CircuitCyborg/Advanced-Weather-Station/Assets/wiringdiagram.png

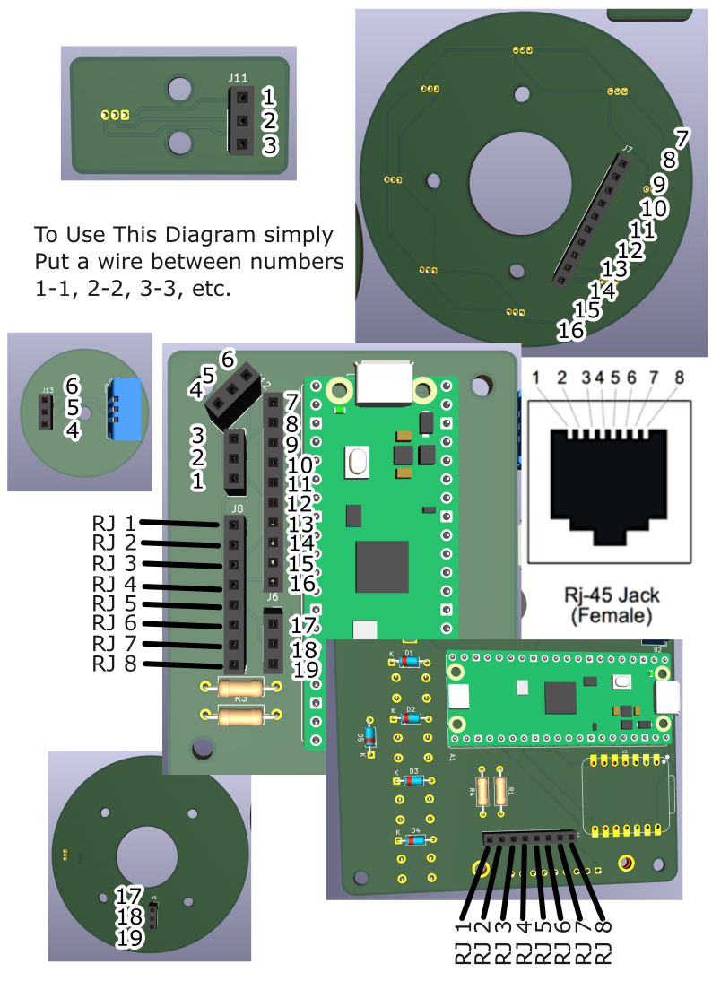
Assets/wiringdiagram.png
