CircuitCyborg/Advanced-Weather-Station/Assets/Layout.png

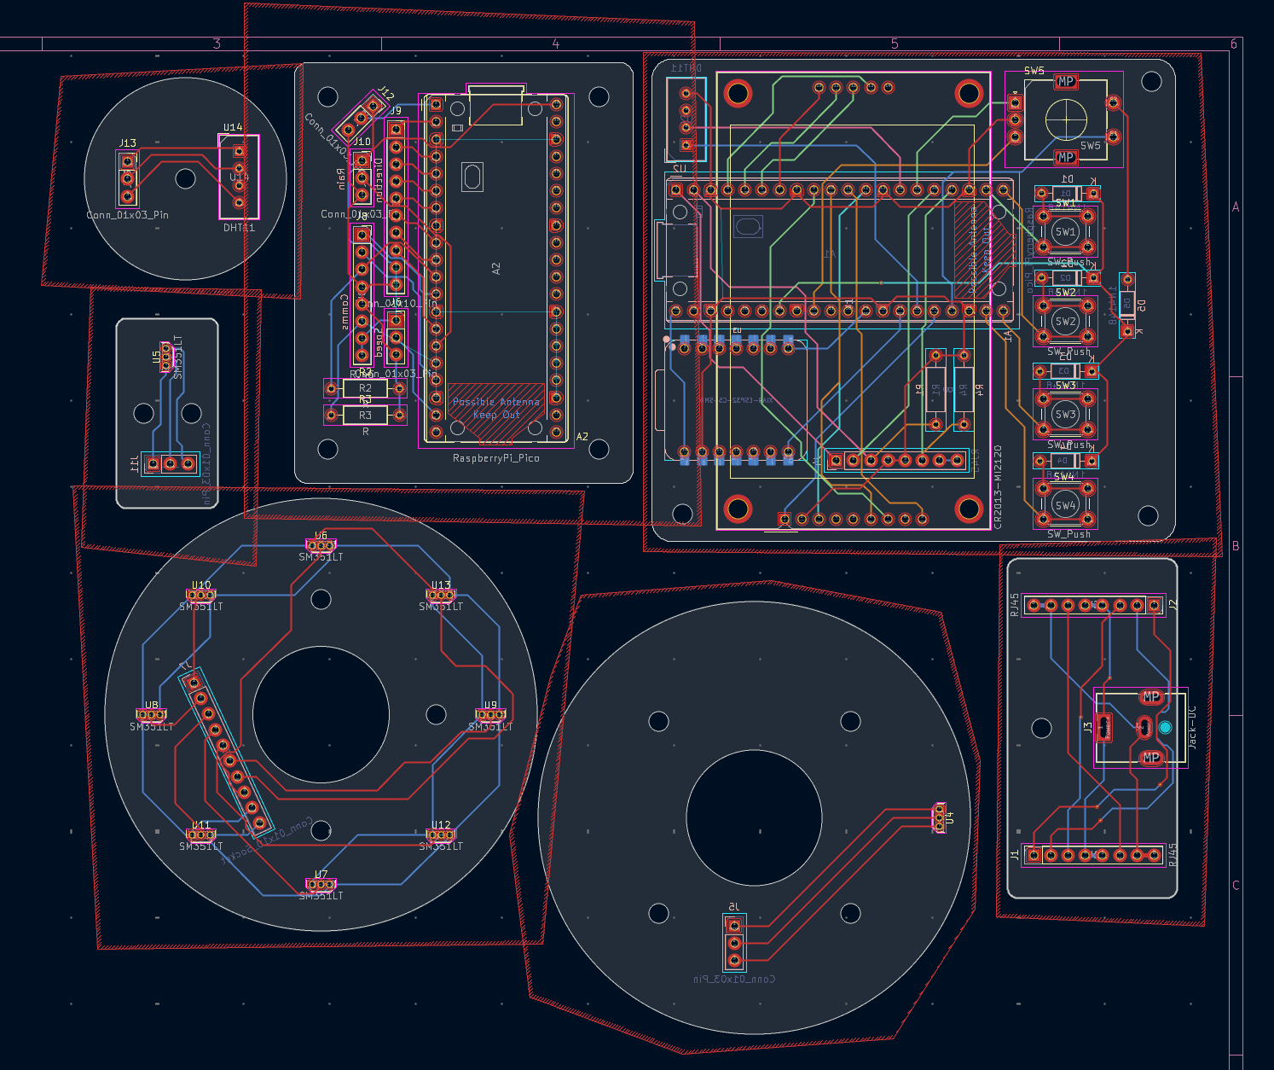
Assets/Layout.png
