CircuitCyborg/Advanced-Weather-Station/Assets/Modules.png

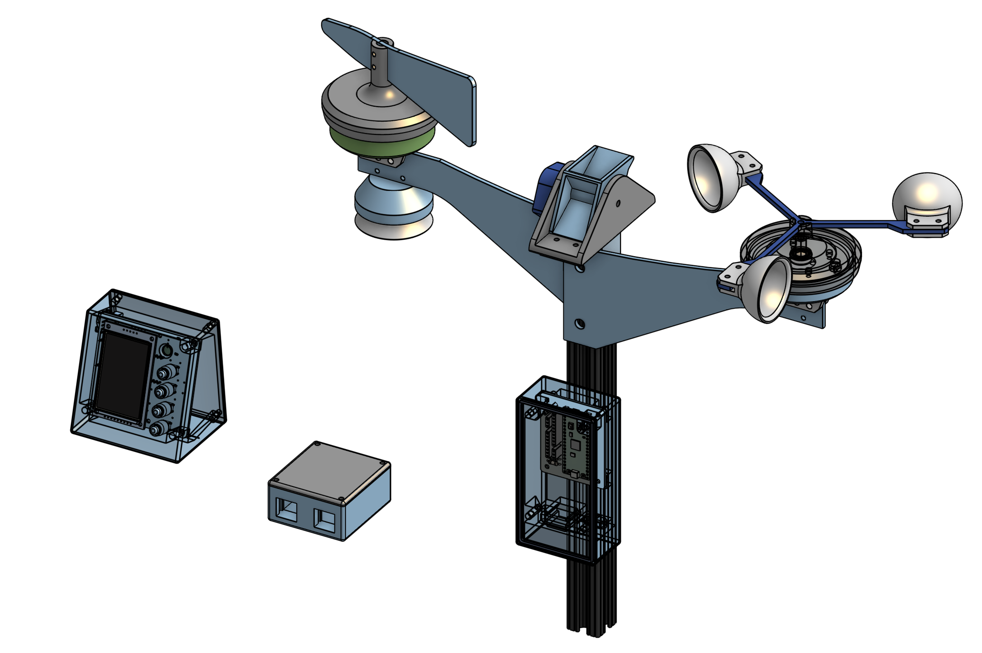
Assets/Modules.png
