CircuitCyborg/Advanced-Weather-Station/Assets/Schematic.png

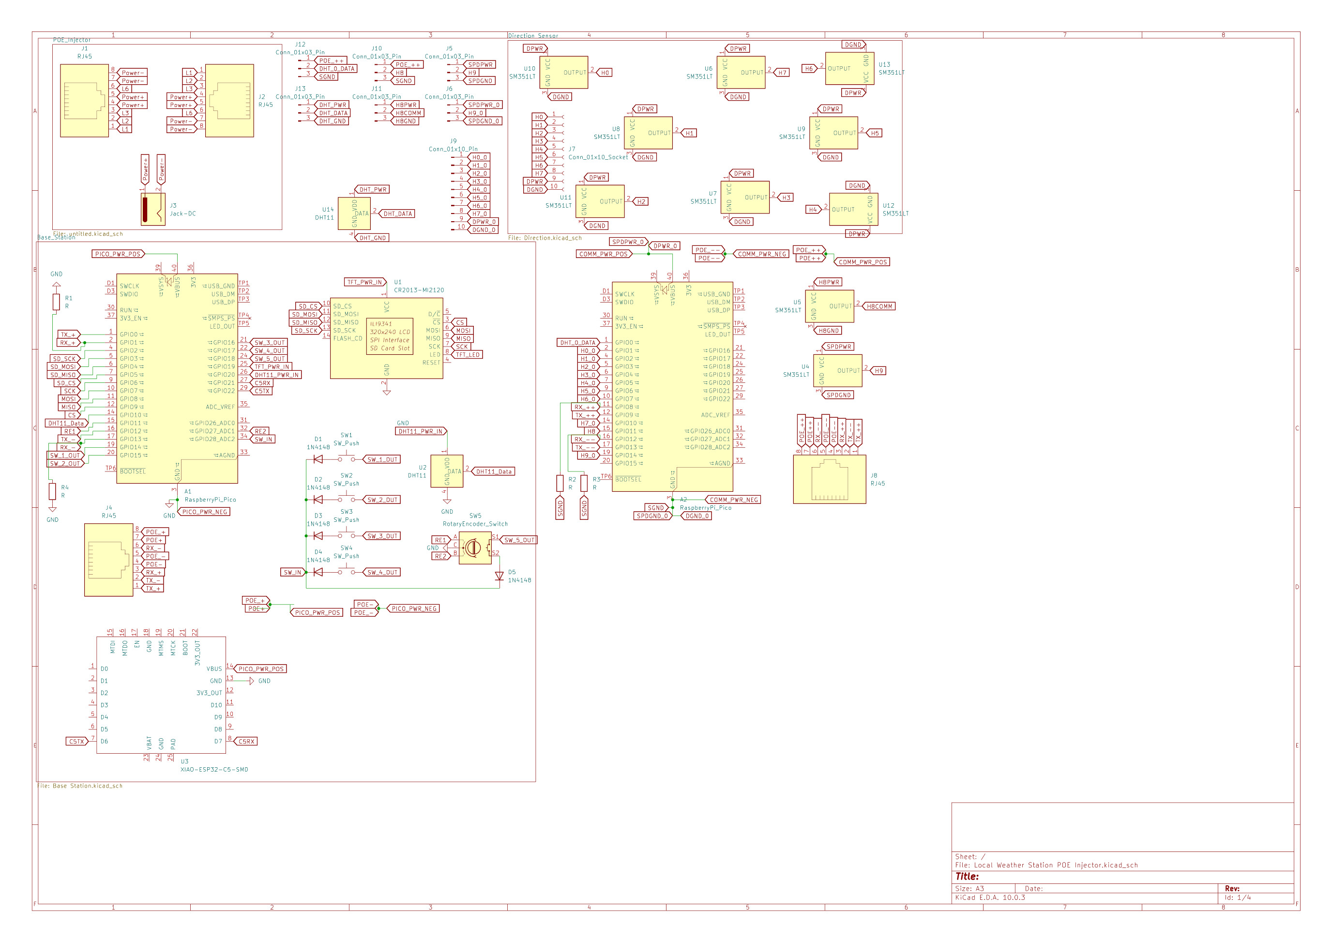
Assets/Schematic.png
