CircuitCyborg/Advanced-Weather-Station/BOM.csv

Item Number | Quantity Needed | Price/Piece | Price for Quantity Needed | Name | Web Link
1. | 2 | $3.95 | $7.90 | AM 2320 Temp and Humidity Sensor | https://www.adafruit.com/product/3721?
2. | 1 | $6.05 | $6.05 | ST7735 TFT Display | https://www.aliexpress.us/item/3256807009276955.html?
3. | 1 / 20 pack | $5.55 | $5.55 | A3144 Hall Sensor | https://www.aliexpress.us/item/3256807009276955.html?
4. | 1 / 10 Piece | $3.76 | $3.76 | 4x10x4 Sealed Flangless Bearing 10 Piece | https://www.aliexpress.us/item/3256807915662185.html?
5. | 2 / 5 Piece | $4.85 | $9.70 | 8x12x3.5 Sealed Flanged Bearings | https://www.aliexpress.us/item/3256809153884282.html?
6. | 1 | $12.31 | $12.31 | Seeed Studio Xiao Esp32-C5 | https://www.aliexpress.us/item/3256811768450465.html?
7. | 2 | $5 | $10 | Raspberry Pi Pico | https://www.adafruit.com/product/4883
8. | 1 | $3.13 | $3.13 | 4.7k ohm resiter 20 pack | https://www.aliexpress.us/item/3256811581264023.html?
9. | 6 | $0.73 | $4.28 | T-Nut Bolt Assembly | https://8020.net/3393.html
10. | 1 | $16.68 | $16.68 | 1010-Black 1x1 t-slot extrusion 24 inch | https://8020.net/1010-black.html
11. | 1 | $3.02 | $3.02 | 5.5x2.5mm Female DC Barrel Jack | https://www.aliexpress.us/item/3256810061502068.html?
12. | 1 | $39.52 | $39.52 | Weather Station PCBs (7 total) | NO LINK (JLC PCB)
13. | 1 | $17.99 | $17.99 | 1/8th in aluminum sheet | https://www.amazon.com/Feelers-Aluminum-Thickness-Protective-Processing/dp/B0BWRQBK73/ref=sr_1_5?
14. | 0 | $2.55 | $0 | EC11E Rotary Encoder | https://www.aliexpress.us/item/3256813351443729.html?
15. | 0 | $1.15 | $0 | 1N4148 THT Diodes | https://www.aliexpress.us/item/3256812018053881.html?
16. | 0 | $1.80 | $0 | 6x6x6 THT Push Button | https://www.aliexpress.us/item/2251832630469941.html?
17. | 0 | $4.19 | $0 | 8x43mm Gobilda Rex Shaft | https://www.gobilda.com/8mm-rex-shaft-with-e-clip-stainless-steel-43mm-length/
18. | 0 | $29.99 | $0 | 100ft Cat 5e cable | https://www.amazon.com/Voltive-Cat5e-Riser-100ft-White/dp/B0F7C79BB1/ref=sr_1_7?
19. | 0 | $11.98 | $0 | Keystone Female RJ45 Jacks | https://www.amazon.com/dp/B0FCBS85S2?ref_=ppx_hzsearch_conn_dt_b_fed_asin_title_3
Total Cost of Needed Items | $151.43 After Tax
Adafruit Total | $19.37
Aliexpress Total | $47.11
JLC PCB Total | $42.78
8020.net Total | $22.69
Amazon | $19.47
