CircuitCyborg/Advanced-Weather-Station/Overall Assy_Advanced_Weather_Station.step

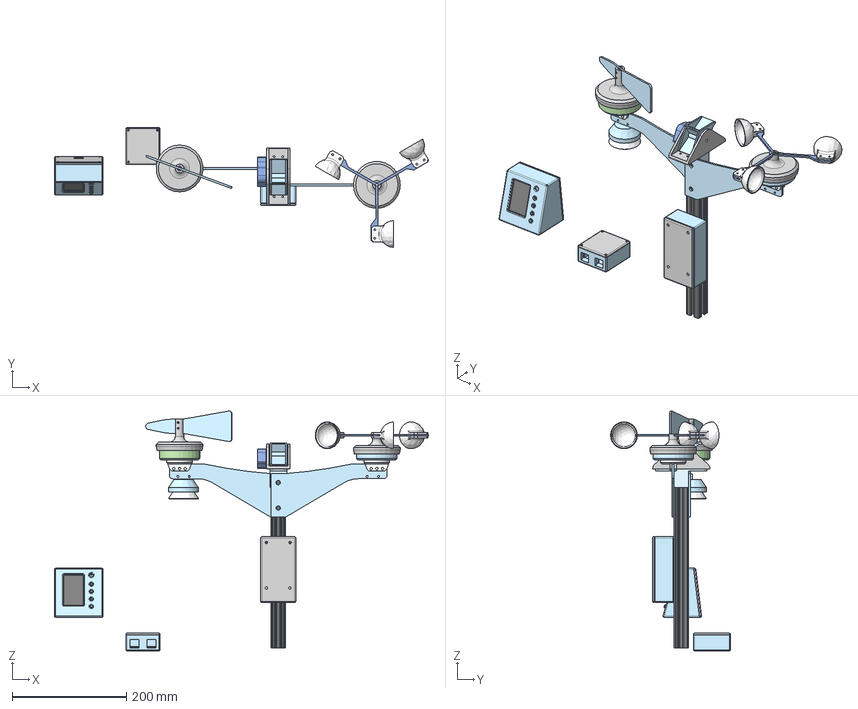
[picture p5: CAD file, 2026-11-01]
Overall Assy_Advanced_Weather_Station.step
654.0 x 209.7 x 419.4 mm
D_DO-35_SOD27_P7.62mm_Horizontal_4 x 2
SW_PUSH_6mm
RaspberryPi_Pico_H_Module_KiCad x 2
D_DO-35_SOD27_P7.62mm_Horizontal_2 x 2
SW_PUSH_6mm_2
D_DO-35_SOD27_P7.62mm_Horizontal x 2
PinSocket_1x08_P2.54mm_Vertical x 2
RaspberryPi_Pico_Header_DIP-40_H2.54mm_KiCad x 2
D_DO-35_SOD27_P7.62mm_Horizontal_3 x 2
Aosong_DHT11_5.5x12.0_P2.54mm
Local Weather Station POE Injector_PCB_7
SW_PUSH_6mm_3
Display_frame_sp x 2
SW_PUSH_6mm_1
Base Station Case Bottom
D_DO-35_SOD27_P7.62mm_Horizontal_1 x 2
R_Axial_DIN0207_L63mm_D25mm_P1016mm_Horizontal_1 x 2
Base Station Case Top
R_Axial_DIN0207_L63mm_D25mm_P1016mm_Horizontal x 2
3382__Imported1 x 2
Local Weather Station POE Injector_PCB_4
TempSensor Top
TempSensor Base
TO-92Flat x 2
Bucket
Mount
MagnetSensor Cover
PinSocket_1x03_P2.54mm_Vertical x 3
Local Weather Station POE Injector_PCB_1
Gasket
DS Mount x 2
outer race x 4
inner race x 4
Windspeed Module Lid
WindSpeedCap
WindSpeedCup x 3
WindSpeedArm
Windspeed Module Base
Local Weather Station POE Injector_PCB_2
Direction Wing
Local Weather Station POE Injector_PCB_6
DirectionCap
Direction Sensor Case Lid
DS Lid Spacer x 3
2106 Series Stainless Steel REX Shaft (8mm Diameter, 43mm Length)
2802 Series Zinc-Plated Steel Button Head Screw (M4 x 0.7mm, 10mm Len gth) 2802-0004-0010
Direction Sensor Case Base
TPU Gasket
Local Weather Station POE Injector_PCB_5
BrainCaseBase
PinSocket_1x03_P2.54mm_Vertical_1
PinSocket_1x03_P2.54mm_Vertical_2
BrainLid
PinSocket_1x10_P2.54mm_Vertical
POE Case Bottom
Local Weather Station POE Injector_PCB_3
BarrelJack_CUI_PJ-063AH_Horizontal
