CircuitCyborg/Advanced-Weather-Station/CAD-Manufacturing/BaseStation/Basestation Main - Base Station Case Top.step

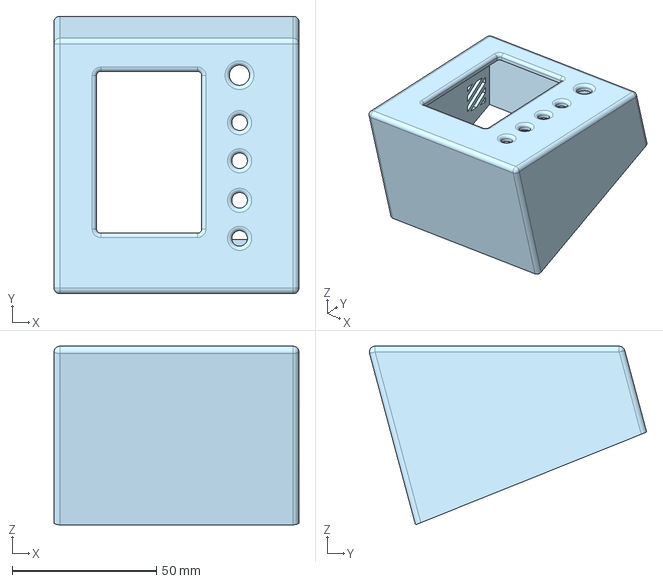
[picture p6: CAD file, 2026-11-01]
CAD-Manufacturing/BaseStation/Basestation Main - Base Station Case Top.step
85.0 x 96.2 x 62.0 mm
