CircuitCyborg/Advanced-Weather-Station/CAD-Manufacturing/BaseStation/Basestation Main - Base Station Case Bottom.step

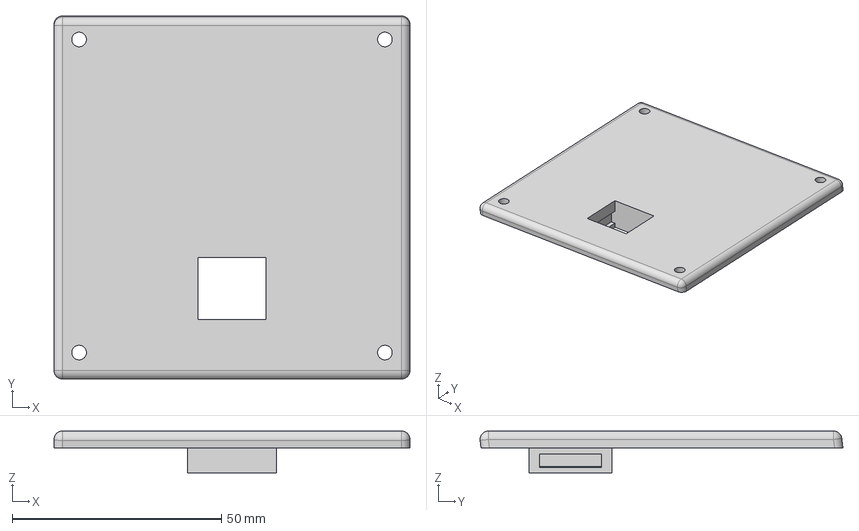
[picture p7: CAD file, 2026-11-01]
CAD-Manufacturing/BaseStation/Basestation Main - Base Station Case Bottom.step
85.0 x 86.7 x 10.0 mm
