CircuitCyborg/Advanced-Weather-Station/CAD-Manufacturing/BaseStation/Extra Parts for Base - Button.step

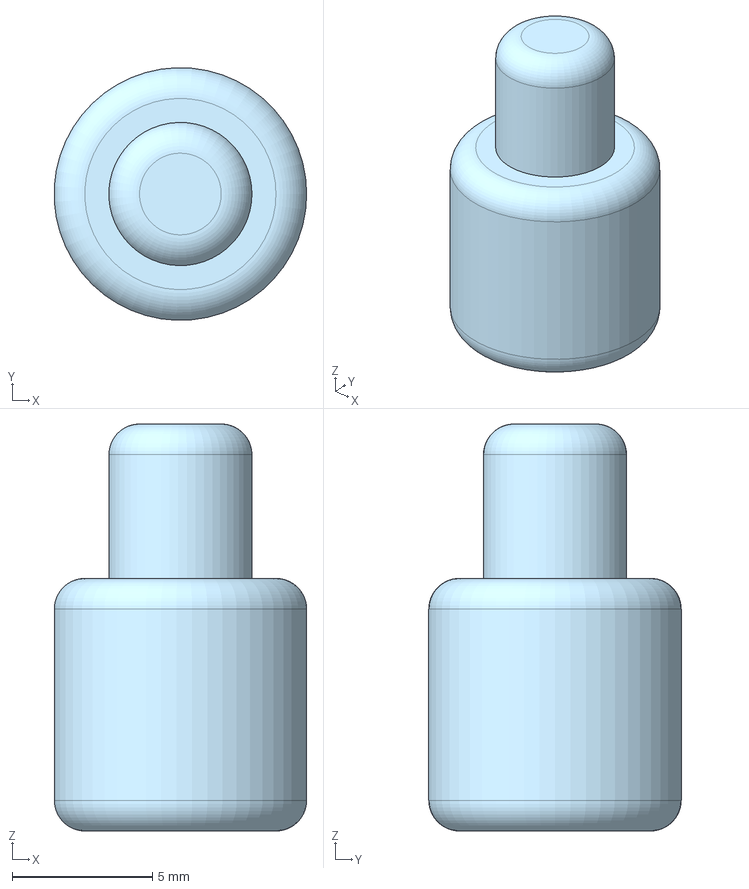
[picture p8: CAD file, 2026-11-01]
CAD-Manufacturing/BaseStation/Extra Parts for Base - Button.step
8.99 x 9.00 x 14.5 mm
