CircuitCyborg/Advanced-Weather-Station/CAD-Manufacturing/BrainBox/BrainBox - TPU Gasket.step

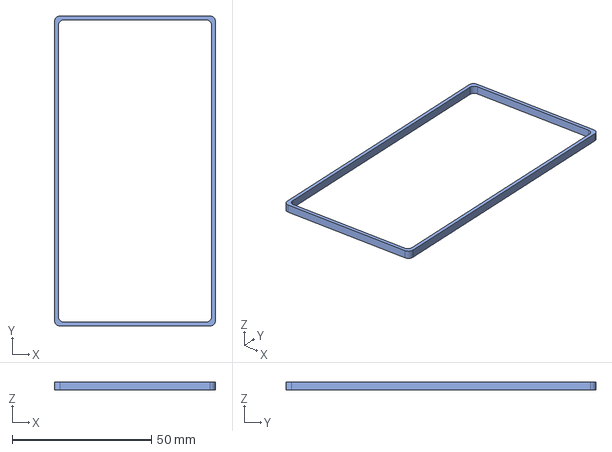
[picture p9: CAD file, 2026-11-01]
CAD-Manufacturing/BrainBox/BrainBox - TPU Gasket.step
57.9 x 111.4 x 3.00 mm
