CircuitCyborg/Advanced-Weather-Station/CAD-Manufacturing/Direction Sensor/Direction Sensor Case - Direction Sensor Case Base.step

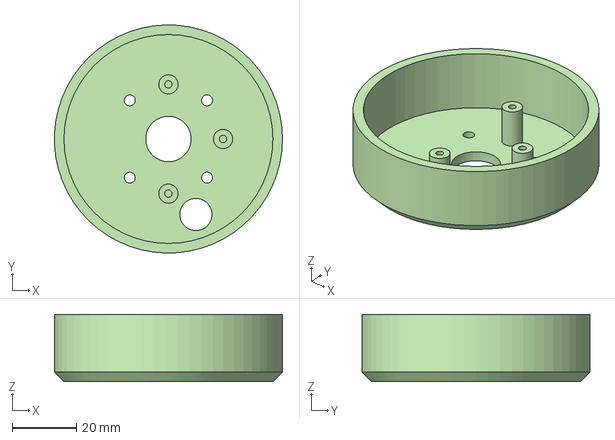
[picture p10: CAD file, 2026-11-01]
CAD-Manufacturing/Direction Sensor/Direction Sensor Case - Direction Sensor Case Base.step
70.9 x 71.0 x 21.0 mm
