CircuitCyborg/Advanced-Weather-Station/CAD-Manufacturing/POE_Injector/POE Injector Case - Top.step

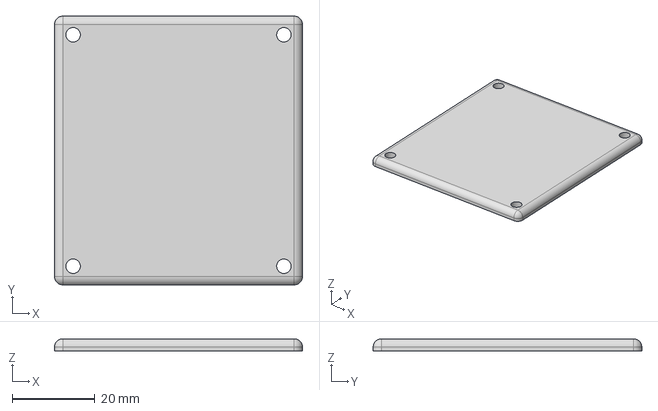
[picture p11: CAD file, 2026-11-01]
CAD-Manufacturing/POE_Injector/POE Injector Case - Top.step
60.0 x 65.0 x 3.00 mm
