CircuitCyborg/Advanced-Weather-Station/CAD-Manufacturing/PrecipSensor/Precip Module - Bucket.step

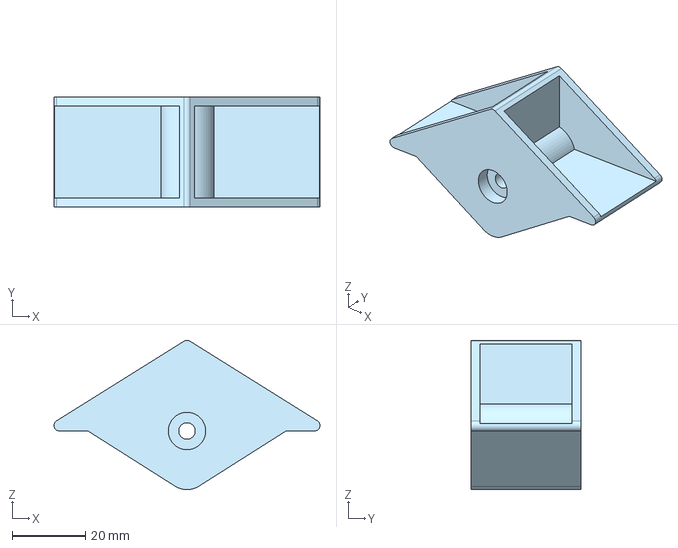
[picture p12: CAD file, 2026-11-01]
CAD-Manufacturing/PrecipSensor/Precip Module - Bucket.step
72.5 x 30.0 x 40.7 mm
