CircuitCyborg/Advanced-Weather-Station/CAD-Manufacturing/Speed Sensor/Wind Speed Wing - WindSpeedArm.step

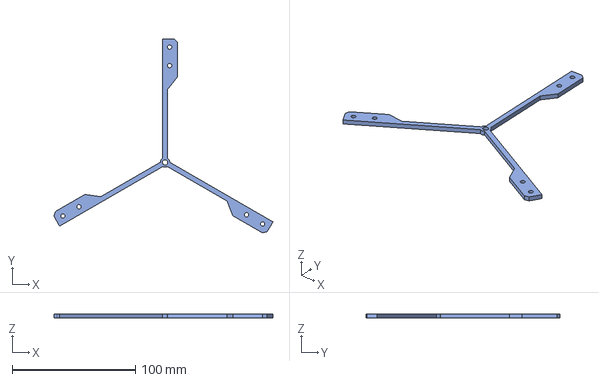
[picture p13: CAD file, 2026-11-01]
CAD-Manufacturing/Speed Sensor/Wind Speed Wing - WindSpeedArm.step
177.7 x 157.2 x 3.17 mm
