CircuitCyborg/Advanced-Weather-Station/CAD-Manufacturing/TempSensorCase/TempHumidity Sensor Case - TempSensor Base.step

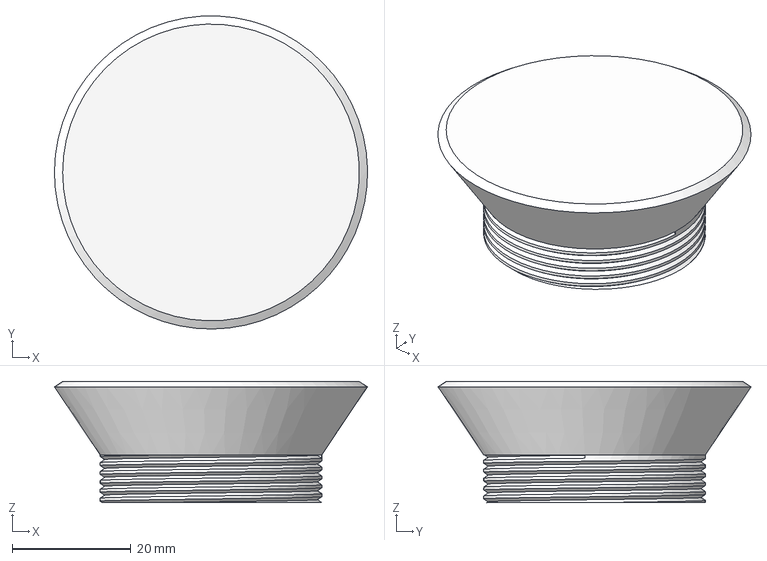
[picture p14: CAD file, 2026-11-01]
CAD-Manufacturing/TempSensorCase/TempHumidity Sensor Case - TempSensor Base.step
52.8 x 52.7 x 20.4 mm
