CircuitCyborg/Advanced-Weather-Station/CAD-Manufacturing/TreeWingCNCFiles/8020-1010-BLACK X 12 - Wing.dxf

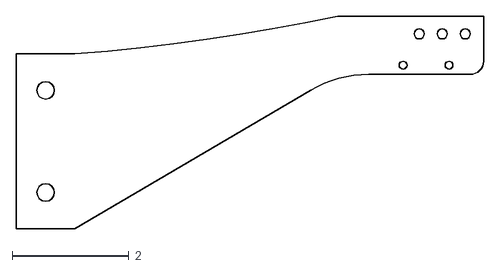
[picture p15: CAD file, 2026-11-01]
CAD-Manufacturing/TreeWingCNCFiles/8020-1010-BLACK X 12 - Wing.dxf
8.00 x 3.65
