CircuitCyborg/Advanced-Weather-Station/CAD-Manufacturing/BrainBox/BrainBox - BrainLid.step

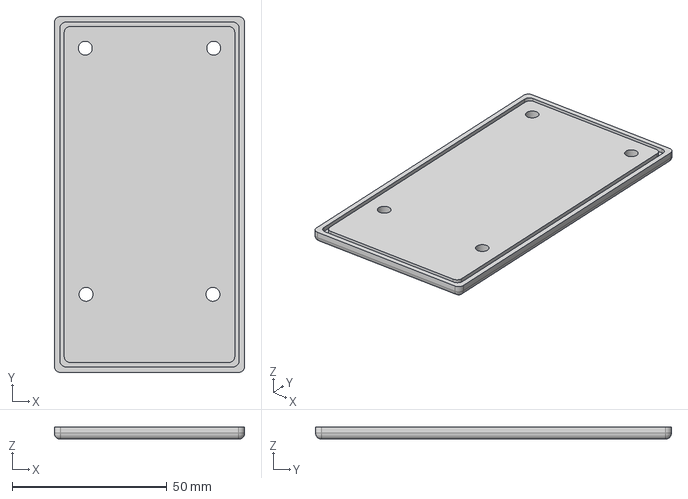
[picture p16: CAD file, 2026-11-01]
CAD-Manufacturing/BrainBox/BrainBox - BrainLid.step
61.5 x 115.0 x 4.00 mm
