CircuitCyborg/Advanced-Weather-Station/CAD-Manufacturing/Direction Sensor/Direction Sensor Wing - DirectionCap.step

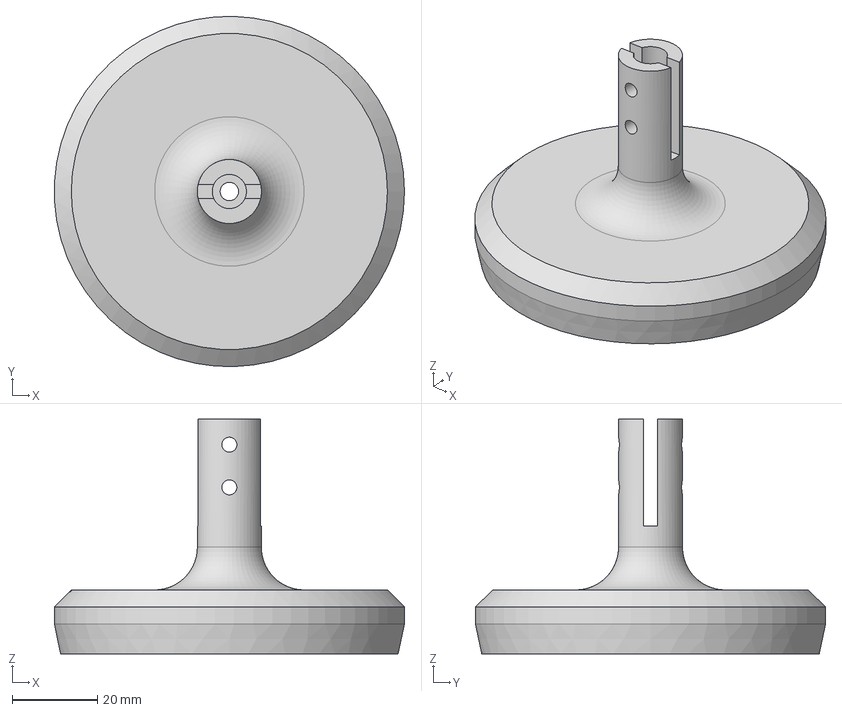
[picture p17: CAD file, 2026-11-01]
CAD-Manufacturing/Direction Sensor/Direction Sensor Wing - DirectionCap.step
81.9 x 82.0 x 55.0 mm
