CircuitCyborg/Advanced-Weather-Station/CAD-Manufacturing/POE_Injector/POE Injector Case - POE Case Bottom.step

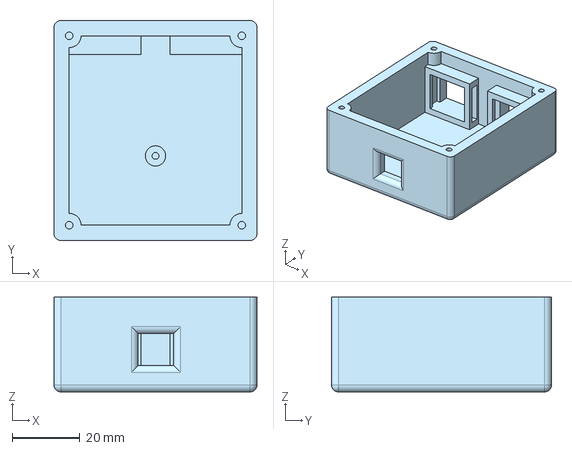
[picture p18: CAD file, 2026-11-01]
CAD-Manufacturing/POE_Injector/POE Injector Case - POE Case Bottom.step
60.0 x 65.0 x 28.0 mm
