CircuitCyborg/Advanced-Weather-Station/CAD-Manufacturing/PrecipSensor/Precip Module - MagnetSensor Cover.step

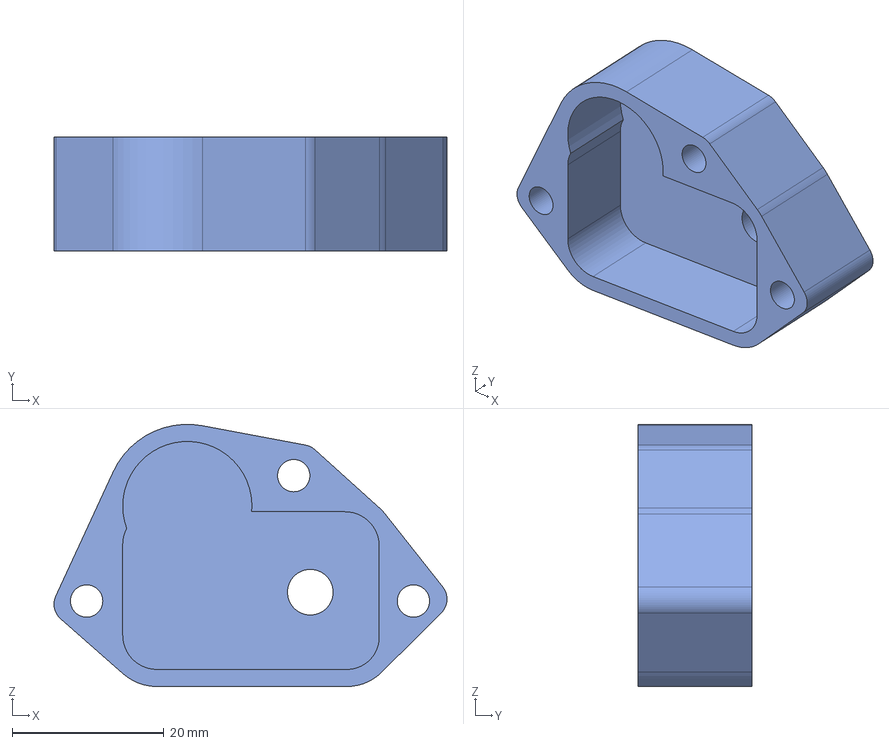
[picture p19: CAD file, 2026-11-01]
CAD-Manufacturing/PrecipSensor/Precip Module - MagnetSensor Cover.step
51.7 x 15.0 x 34.5 mm
