CircuitCyborg/Advanced-Weather-Station/CAD-Manufacturing/Speed Sensor/Direction Sensor Case - DS Mount.step

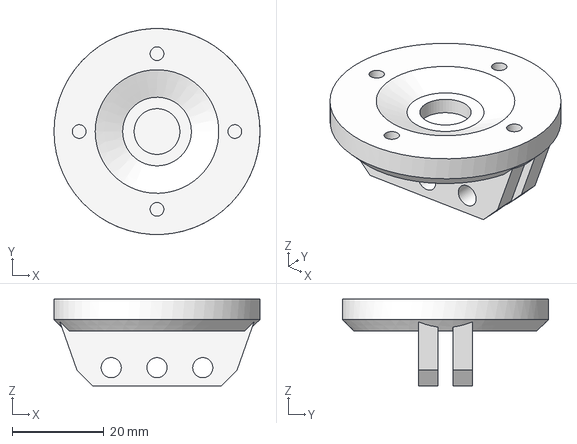
[picture p20: CAD file, 2026-11-01]
CAD-Manufacturing/Speed Sensor/Direction Sensor Case - DS Mount.step
45.0 x 45.0 x 19.0 mm
