CircuitCyborg/Advanced-Weather-Station/CAD-Manufacturing/TempSensorCase/Precip Module - Mount.step

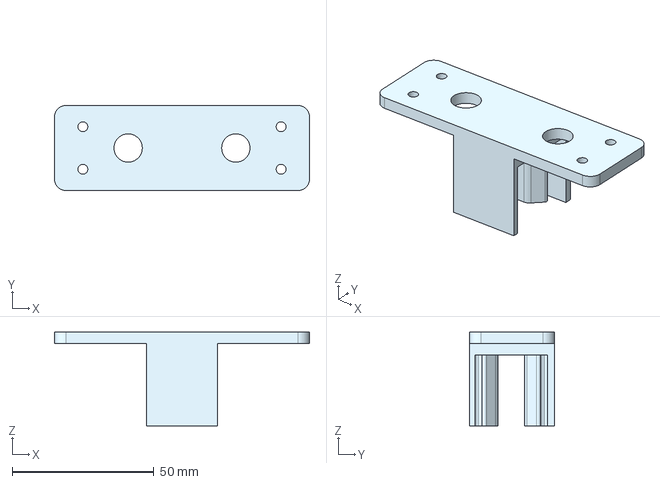
[picture p21: CAD file, 2026-11-01]
CAD-Manufacturing/TempSensorCase/Precip Module - Mount.step
90.0 x 30.0 x 33.0 mm
