CircuitCyborg/Advanced-Weather-Station/CAD-Manufacturing/TreeWingCNCFiles/Direction Sensor Wing - Direction Wing.dxf

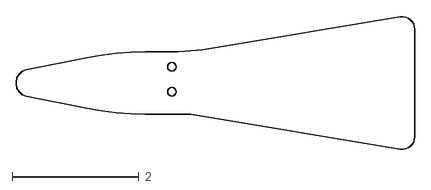
[picture p22: CAD file, 2026-11-01]
CAD-Manufacturing/TreeWingCNCFiles/Direction Sensor Wing - Direction Wing.dxf
6.30 x 2.11
