CircuitCyborg/Advanced-Weather-Station/CAD-Manufacturing/BrainBox/BrainBox - BrainCaseBase.step

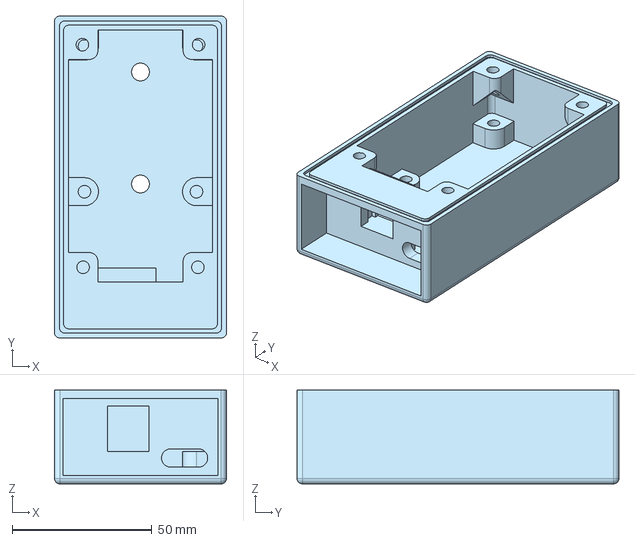
[picture p23: CAD file, 2026-11-01]
CAD-Manufacturing/BrainBox/BrainBox - BrainCaseBase.step
61.5 x 115.0 x 33.5 mm
