CircuitCyborg/Advanced-Weather-Station/CAD-Manufacturing/Direction Sensor/Direction Sensor Case - DS Lid Spacer.step

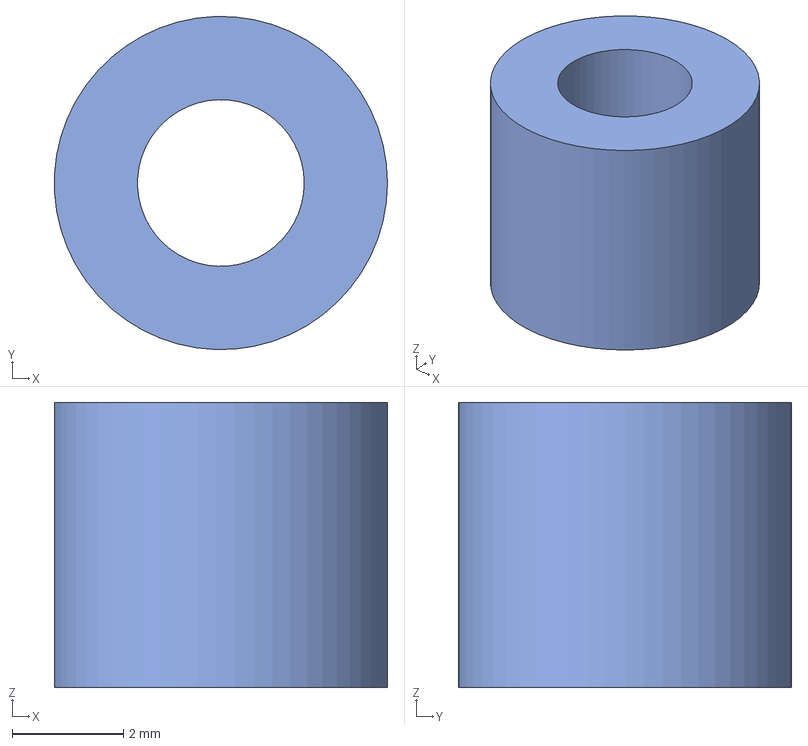
[picture p24: CAD file, 2026-11-01]
CAD-Manufacturing/Direction Sensor/Direction Sensor Case - DS Lid Spacer.step
6.00 x 6.00 x 5.13 mm
