CircuitCyborg/Advanced-Weather-Station/CAD-Manufacturing/PrecipSensor/Precip Module - Gasket.step

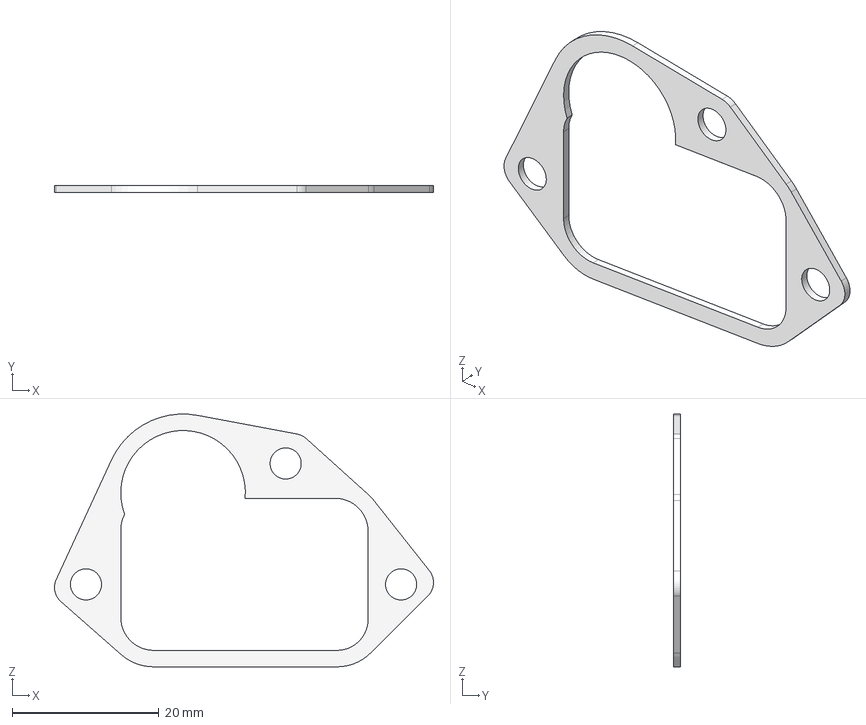
[picture p25: CAD file, 2026-11-01]
CAD-Manufacturing/PrecipSensor/Precip Module - Gasket.step
51.7 x 1.00 x 34.5 mm
