CircuitCyborg/Advanced-Weather-Station/CAD-Manufacturing/Speed Sensor/Wind Speed Wing - WindSpeedCap.step

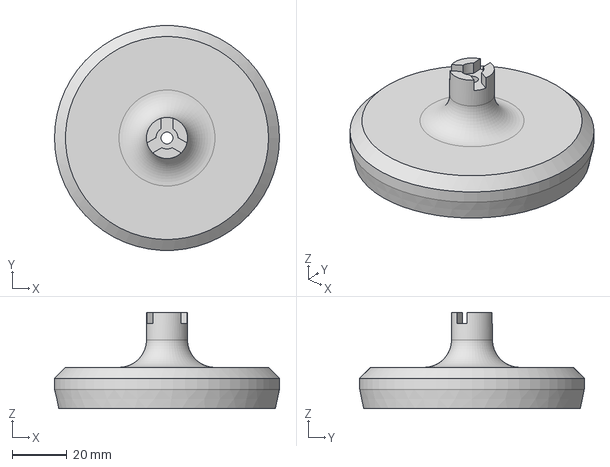
[picture p26: CAD file, 2026-11-01]
CAD-Manufacturing/Speed Sensor/Wind Speed Wing - WindSpeedCap.step
82.0 x 81.9 x 35.0 mm
