CircuitCyborg/Advanced-Weather-Station/CAD-Manufacturing/TempSensorCase/TempHumidity Sensor Case - TempSensor Top.step

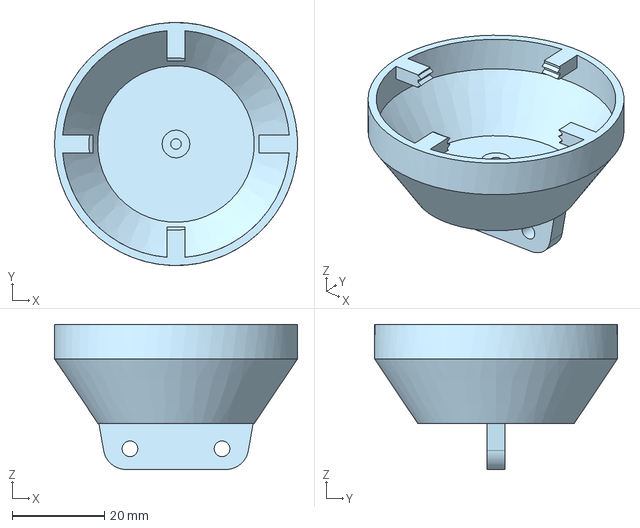
[picture p27: CAD file, 2026-11-01]
CAD-Manufacturing/TempSensorCase/TempHumidity Sensor Case - TempSensor Top.step
52.8 x 52.8 x 31.5 mm
