CircuitCyborg/Advanced-Weather-Station/CAD-Manufacturing/TreeWingCNCFiles/Wind Speed Wing - WindSpeedArm.dxf

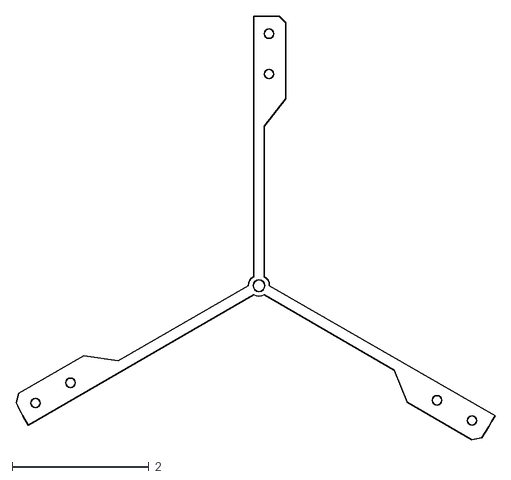
[picture p28: CAD file, 2026-11-01]
CAD-Manufacturing/TreeWingCNCFiles/Wind Speed Wing - WindSpeedArm.dxf
7.00 x 6.19
