CircuitCyborg/Advanced-Weather-Station/CAD-Manufacturing/Direction Sensor/Direction Sensor Case - Direction Sensor Case Lid.step

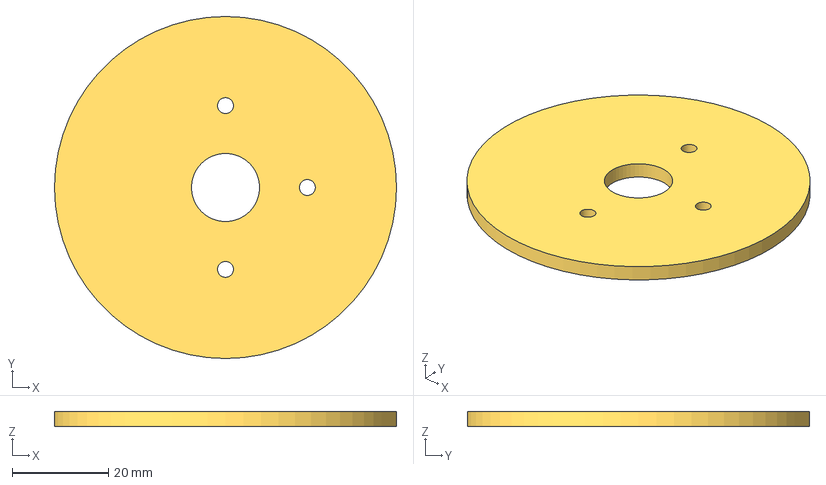
[picture p29: CAD file, 2026-11-01]
CAD-Manufacturing/Direction Sensor/Direction Sensor Case - Direction Sensor Case Lid.step
71.0 x 71.0 x 3.17 mm
