CircuitCyborg/Advanced-Weather-Station/CAD-Manufacturing/PrecipSensor/Precip Module - Mount.step

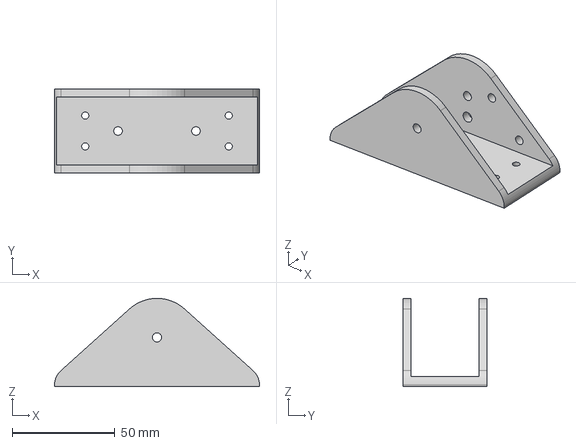
[picture p30: CAD file, 2026-11-01]
CAD-Manufacturing/PrecipSensor/Precip Module - Mount.step
100.0 x 41.0 x 43.1 mm
