CircuitCyborg/Advanced-Weather-Station/CAD-Manufacturing/Speed Sensor/Wind Speed Sensor Case - Windspeed Module Base.step

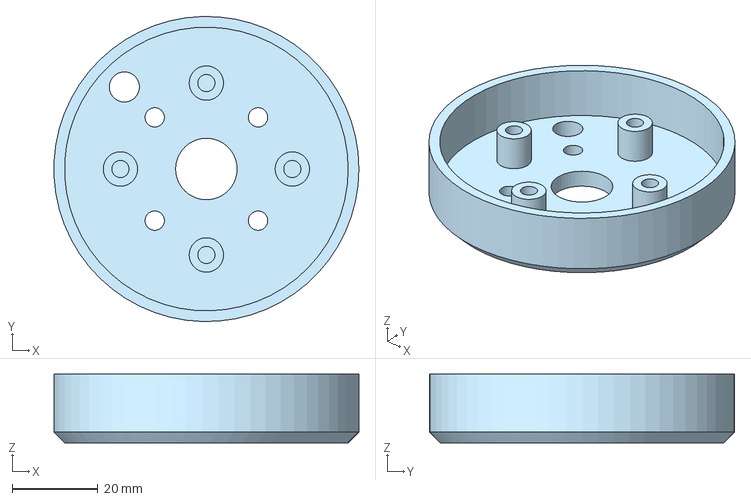
[picture p31: CAD file, 2026-11-01]
CAD-Manufacturing/Speed Sensor/Wind Speed Sensor Case - Windspeed Module Base.step
70.9 x 71.0 x 16.0 mm
