CircuitCyborg/Advanced-Weather-Station/CAD-Manufacturing/Speed Sensor/Wind Speed Wing - WindSpeedCup(print 3).step

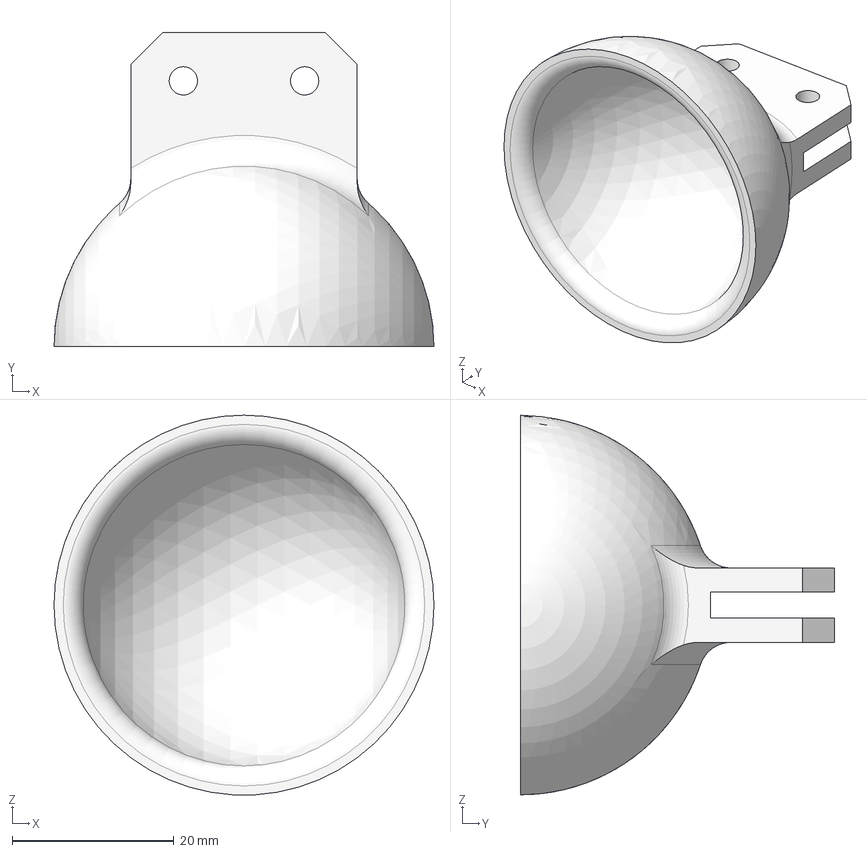
[picture p32: CAD file, 2026-11-01]
CAD-Manufacturing/Speed Sensor/Wind Speed Wing - WindSpeedCup(print 3).step
47.0 x 38.9 x 47.0 mm
