CircuitCyborg/Advanced-Weather-Station/(list of files, cad)

Other CAD files:
CAD-Manufacturing/Speed Sensor/Wind Speed Sensor Case - Windspeed Module Lid.step
