CircuitCyborg/Advanced-Weather-Station/PCB_Production/WeatherStation PCB SOURCE/Local Weather Station POE Injector.kicad_pcb

## KiCad design PCB_Production/WeatherStation PCB SOURCE/Local Weather Station POE Injector.kicad_pcb (2026-11-13)

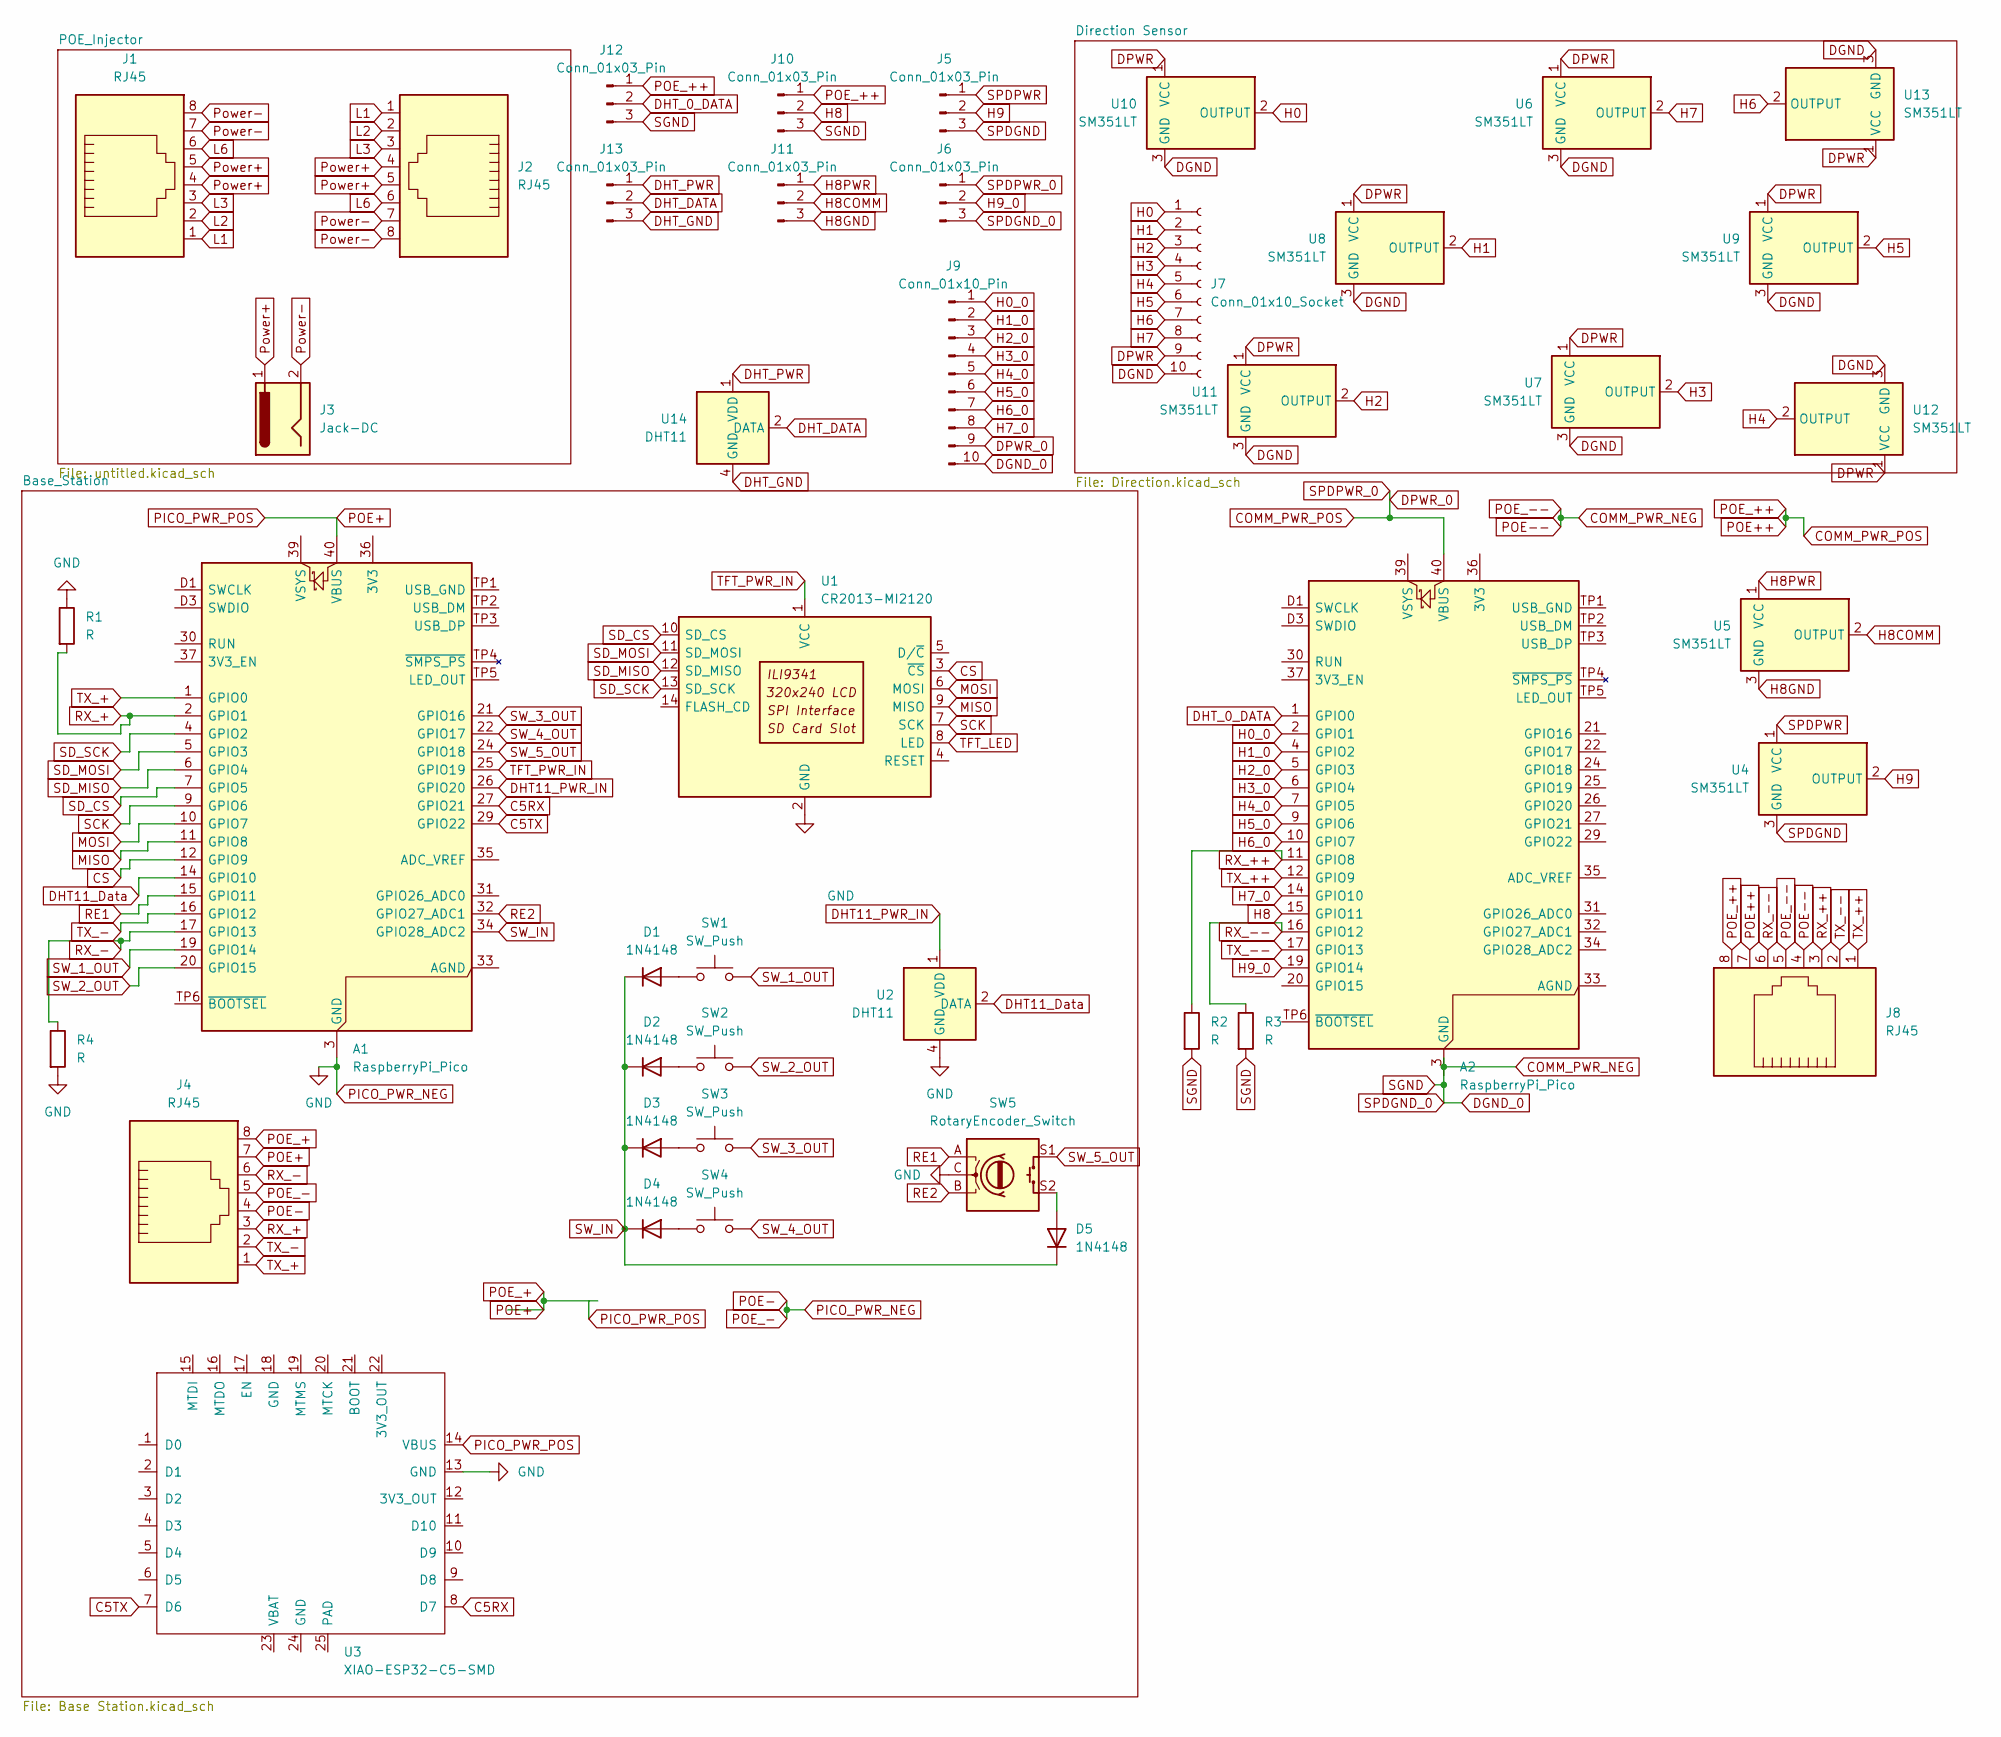
[picture p33: schematic Local Weather Station POE Injector.kicad_sch]

Parts:
A1, A2: RaspberryPi_Pico; RaspberryPi_Pico_Common_THT
D1, D2, D3, D4, D5: 1N4148; D_DO-35_SOD27_P7.62mm_Horizontal
J1, J2, J4, J8: RJ45; PinSocket_1x08_P2.54mm_Vertical
J3: Jack-DC; BarrelJack_CUI_PJ-063AH_Horizontal
J5, J6, J10, J11, J12, J13: Conn_01x03_Pin; PinSocket_1x03_P2.54mm_Vertical
J7: Conn_01x10_Socket; PinSocket_1x10_P2.54mm_Vertical
J9: Conn_01x10_Pin; PinSocket_1x10_P2.54mm_Vertical
R1, R2, R3, R4: R; R_Axial_DIN0207_L6.3mm_D2.5mm_P10.16mm_Horizontal
SW1, SW2, SW3, SW4: SW_Push; SW_PUSH_6mm
SW5: RotaryEncoder_Switch; RotaryEncoder_Alps_EC11E-Switch_Vertical_H20mm
U1: CR2013-MI2120
U2, U14: DHT11; Aosong_DHT11_5.5x12.0_P2.54mm
U3: XIAO-ESP32-C5-SMD; XIAO-RP2040-DIP
U4, U5, U6, U7, U8, U9, U10, U11, U12, U13: SM351LT; TO-92Flat

Connections:
C5RX: A1.27 (GPIO21), U3.8 (D7)
C5TX: A1.29 (GPIO22), U3.7 (D6)
COMM_PWR_NEG: J6.3, J8.4, J8.5, J9.10, J10.3, J12.3, R2.2, R3.2
COMM_PWR_POS: A2.40 (VBUS), J6.1, J8.7, J8.8, J9.9, J10.1, J12.1
CS: A1.12 (GPIO9), U1.3 (~CS)
DGND: J7.10, U6.3 (GND), U7.3 (GND), U8.3 (GND), U9.3 (GND), U10.3 (GND), U11.3 (GND), U12.3 (GND), U13.3 (GND)
DHT11_Data: A1.14 (GPIO10), U2.2 (DATA)
DHT11_PWR_IN: A1.26 (GPIO20), U2.1 (VDD)
DHT_0_DATA: A2.1 (GPIO0), J12.2
DHT_DATA: J13.2, U14.2 (DATA)
DHT_GND: J13.3, U14.4 (GND)
DHT_PWR: J13.1, U14.1 (VDD)
DPWR: J7.9, U6.1 (VCC), U7.1 (VCC), U8.1 (VCC), U9.1 (VCC), U10.1 (VCC), U11.1 (VCC), U12.1 (VCC), U13.1 (VCC)
H0: J7.1, U10.2 (OUTPUT)
H0_0: A2.2 (GPIO1), J9.1
H1: J7.2, U8.2 (OUTPUT)
H1_0: A2.4 (GPIO2), J9.2
H2: J7.3, U11.2 (OUTPUT)
H2_0: A2.5 (GPIO3), J9.3
H3: J7.4, U7.2 (OUTPUT)
H3_0: A2.6 (GPIO4), J9.4
H4: J7.5, U12.2 (OUTPUT)
H4_0: A2.7 (GPIO5), J9.5
H5: J7.6, U9.2 (OUTPUT)
H5_0: A2.9 (GPIO6), J9.6
H6: J7.7, U13.2 (OUTPUT)
H6_0: A2.10 (GPIO7), J9.7
H7: J7.8, U6.2 (OUTPUT)
H7_0: A2.14 (GPIO10), J9.8
H8: A2.15 (GPIO11), J10.2
H8COMM: J11.2, U5.2 (OUTPUT)
H8GND: J11.3, U5.3 (GND)
H8PWR: J11.1, U5.1 (VCC)
H9: J5.2, U4.2 (OUTPUT)
H9_0: A2.19 (GPIO14), J6.2
L1: J1.1, J2.1
L2: J1.2, J2.2
L3: J1.3, J2.3
L6: J1.6, J2.6
MISO: A1.11 (GPIO8), U1.9 (MISO)
MOSI: A1.10 (GPIO7), U1.6 (MOSI)
unnamed: A2.3 (GND), A2.8 (GND), A2.13 (GND), A2.18 (GND), A2.23 (GND), A2.28 (GND), A2.38 (GND), A2.D2 (GND)
unnamed: D1.2 (A), SW1.1
unnamed: D2.2 (A), SW2.1
unnamed: D3.2 (A), SW3.1
unnamed: D4.2 (A), SW4.1
unnamed: D5.2 (A), SW5.S2
PICO_PWR_NEG: A1.3 (GND), A1.8 (GND), A1.13 (GND), A1.18 (GND), A1.23 (GND), A1.28 (GND), A1.38 (GND), A1.D2 (GND), J4.4, J4.5, R1.1, R4.2, SW5.C, U1.2 (GND), U2.4 (GND), U3.13 (GND)
PICO_PWR_POS: A1.40 (VBUS), J4.7, J4.8, U3.14 (VBUS)
Power+: J1.4, J1.5, J2.4, J2.5, J3.1
Power-: J1.7, J1.8, J2.7, J2.8, J3.2
RE1: A1.15 (GPIO11), SW5.A
RE2: A1.32 (GPIO27_ADC1), SW5.B
RX_+: A1.2 (GPIO1), J4.3, R1.2
RX_++: A2.11 (GPIO8), J8.3, R2.1
RX_-: A1.17 (GPIO13), J4.6, R4.1
RX_--: A2.16 (GPIO12), J8.6, R3.1
SCK: A1.9 (GPIO6), U1.7 (SCK)
SD_CS: A1.7 (GPIO5), U1.10 (SD_CS)
SD_MISO: A1.6 (GPIO4), U1.12 (SD_MISO)
SD_MOSI: A1.5 (GPIO3), U1.11 (SD_MOSI)
SD_SCK: A1.4 (GPIO2), U1.13 (SD_SCK)
SPDGND: J5.3, U4.3 (GND)
SPDPWR: J5.1, U4.1 (VCC)
SW_1_OUT: A1.19 (GPIO14), SW1.2
SW_2_OUT: A1.20 (GPIO15), SW2.2
SW_3_OUT: A1.21 (GPIO16), SW3.2
SW_4_OUT: A1.22 (GPIO17), SW4.2
SW_5_OUT: A1.24 (GPIO18), SW5.S1
SW_IN: A1.34 (GPIO28_ADC2), D1.1 (K), D2.1 (K), D3.1 (K), D4.1 (K), D5.1 (K)
TFT_LED: U1.8 (LED)
TFT_PWR_IN: A1.25 (GPIO19), U1.1 (VCC)
TX_+: A1.1 (GPIO0), J4.1
TX_++: A2.12 (GPIO9), J8.1
TX_-: A1.16 (GPIO12), J4.2
TX_--: A2.17 (GPIO13), J8.2

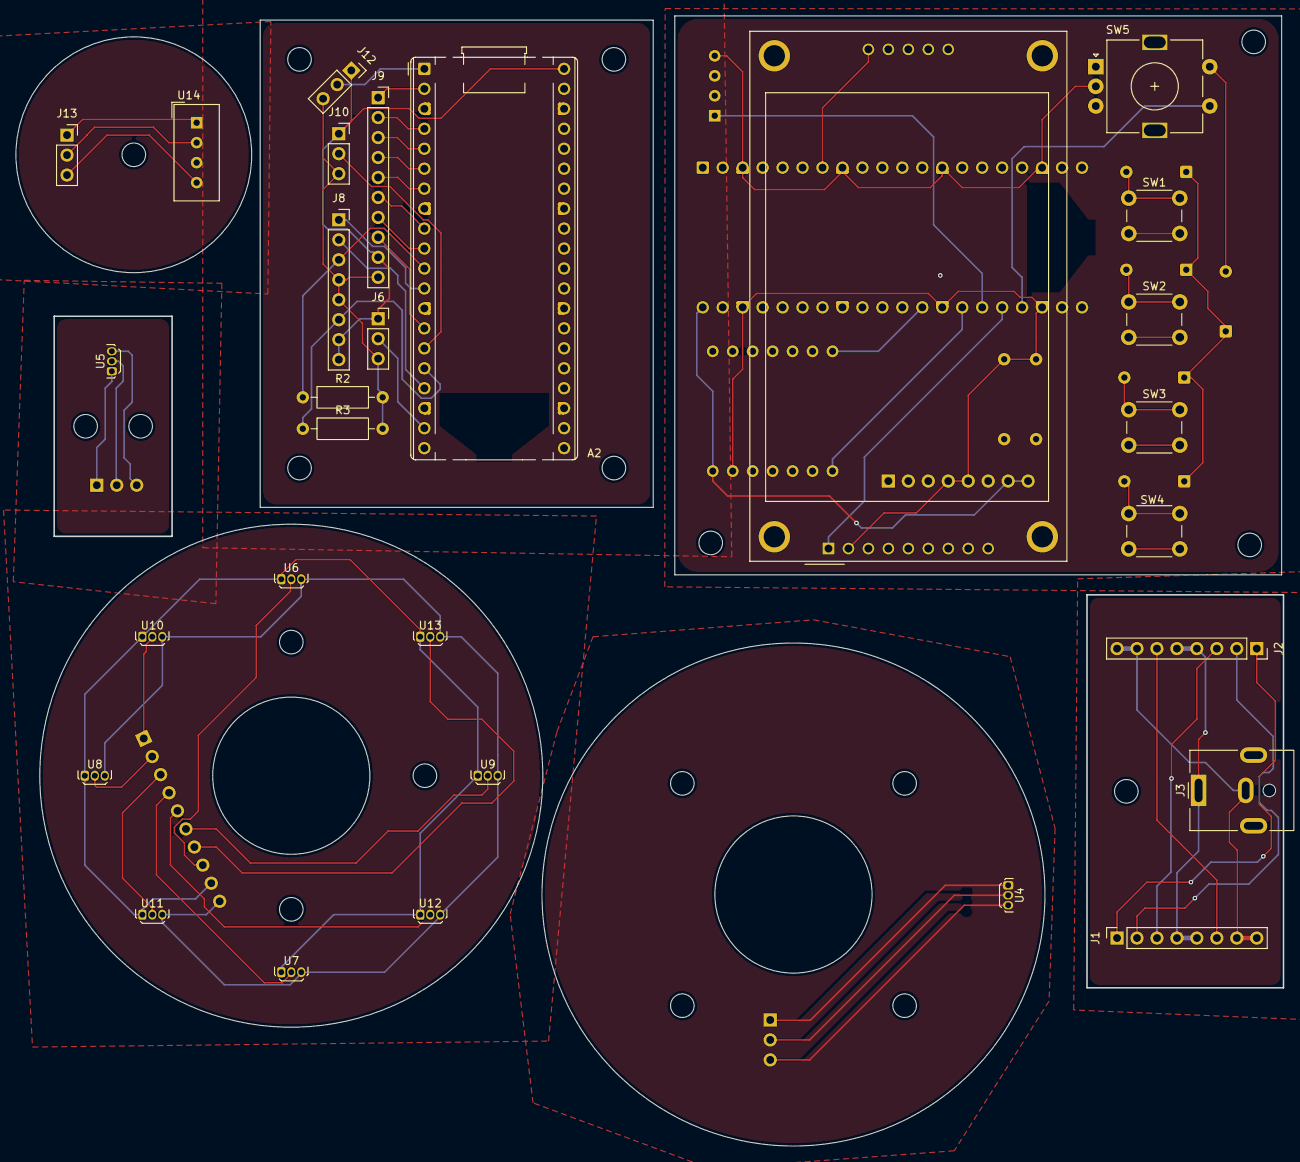
[picture p34: board Local Weather Station POE Injector.kicad_pcb from above]

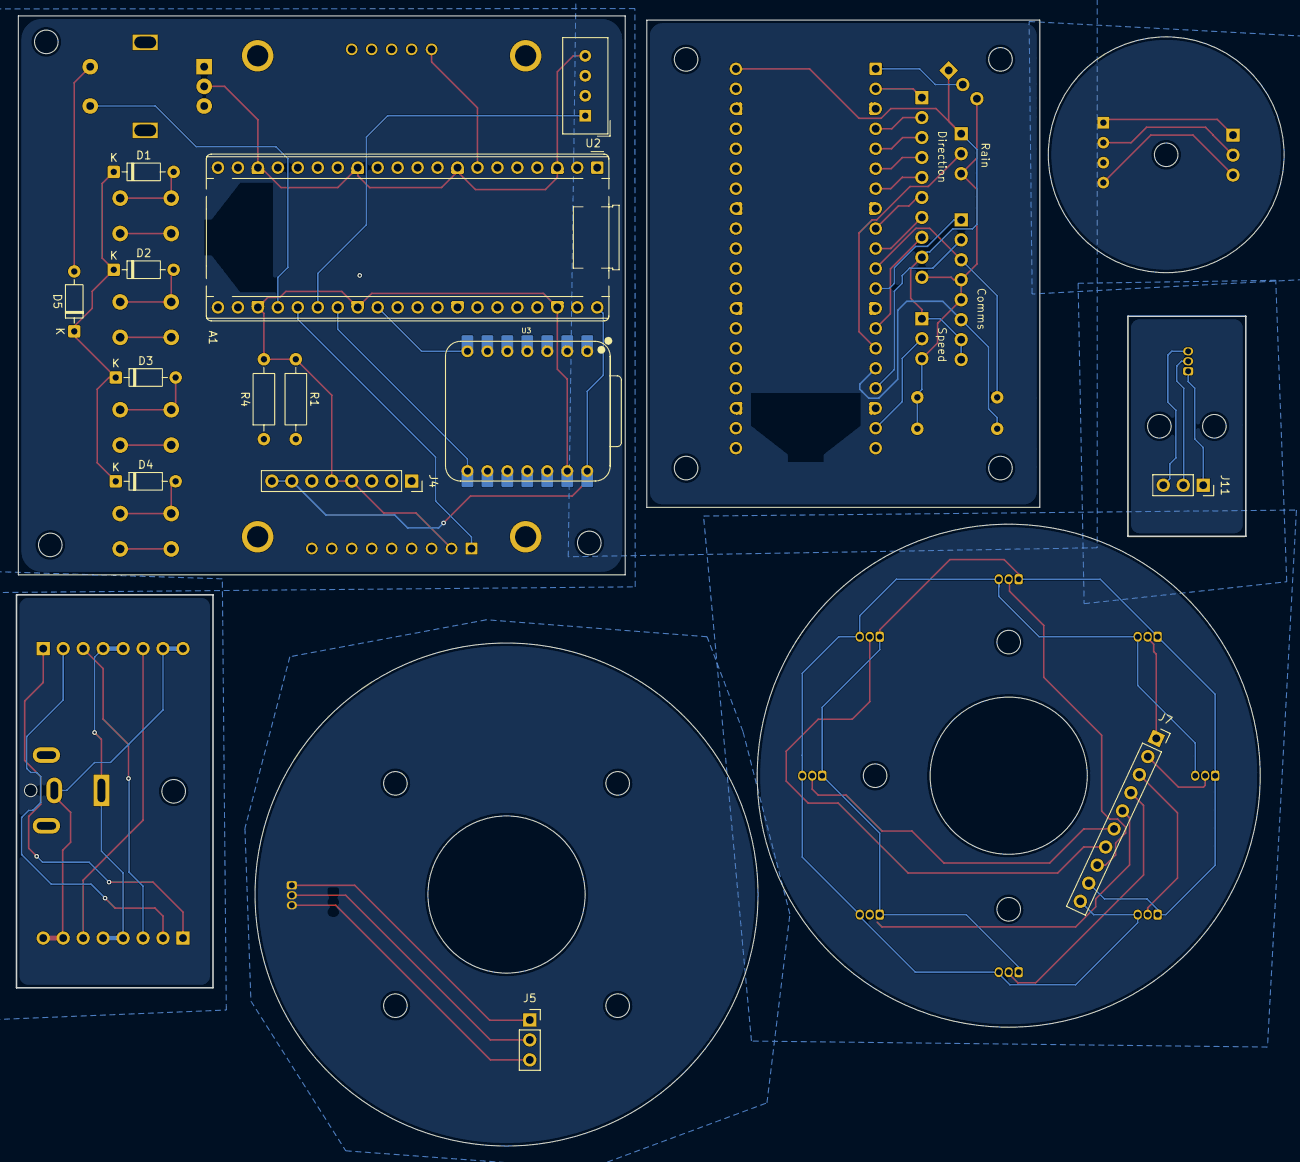
[picture p35: board Local Weather Station POE Injector.kicad_pcb from below]

Board: 6 copper layers, 161.3 x 143.8 mm, 43 parts (14 on the bottom side), 75 nets.
