CircuitCyborg/Advanced-Weather-Station/(commit log)

2026-11-01 Initial Upload of Files
    [8020-1010-BLACK X 12 - Wing.dxf, Basestation Main - Base Station Case Bottom.step, Basestation Main - Base Station Case Top.step, BrainBox - BrainCaseBase.step, BrainBox - BrainLid.step, BrainBox - TPU Gasket.step, Direction Sensor Case - DS Lid Spacer.step, Direction Sensor Case - DS Mount.step]
2026-11-01 Uploading BOM
    [BOM.csv]
2026-11-01 Add overall assy file
    [Overall Assy_Advanced_Weather_Station.step]
2026-11-01 Enhance README with project purpose and wiring details
    Added detailed project purpose and wiring instructions.
2026-11-01 Include wiring diagram and additional images in README
    Added wiring diagram and images for project setup.
2026-11-01 Replace wiring diagram image in README
    Updated wiring diagram image in README.
2026-11-01 Revise BOM.csv with updated item costs
    Updated BOM with new pricing and total costs after tax.
    [BOM.csv]
2026-11-01 Update BOM.csv with new item entries
    [BOM.csv]
2026-11-01 Revise item details and total costs in BOM.csv
    Updated item quantities and prices in BOM.csv, including total costs for each supplier.
    [BOM.csv]
2026-11-13 Update README with wiring diagram and images
    Added a wiring diagram and updated image references in the README.
2026-11-13 Add wiring diagram to README
    Added wiring diagram image to README.
2026-11-13 Add PCB badge link to README
    Added a badge link to view the PCB design on KiCanvas.
2026-11-13 Update PCB link in README.md
